codexnovus/weather_station/README.md

# ESP32 E-ink Board

This project started as a weather station powered by an ESP32 and mounted on a Waveshare 4.2 E-paper display.

Current objective is to make it a platform for developing E-ink solutions. Time will tell if I manage to do that :/
