codexnovus/weather_station/Datasheets/Shield/AZDelivery-ESP32-DevKitCV4-pinout.jpg

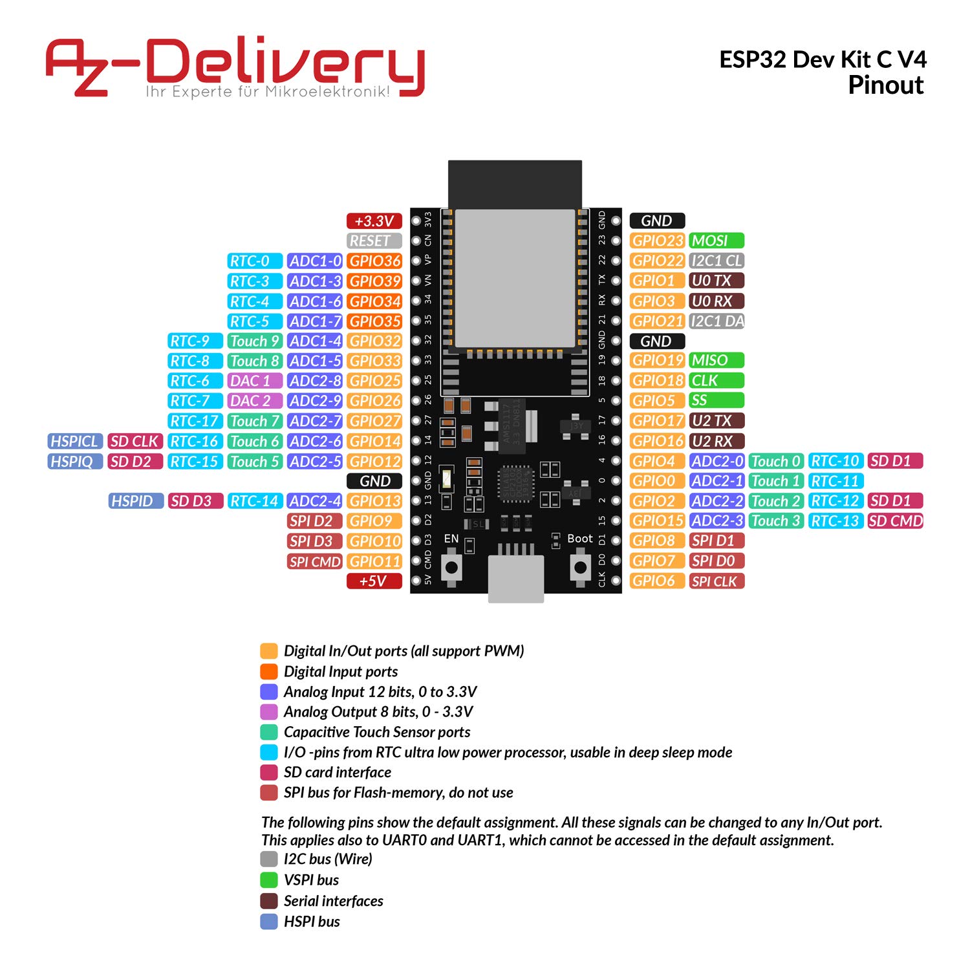
Datasheets/Shield/AZDelivery-ESP32-DevKitCV4-pinout.jpg
