codexnovus/weather_station/Models/Enclosure-Body-Preview.png

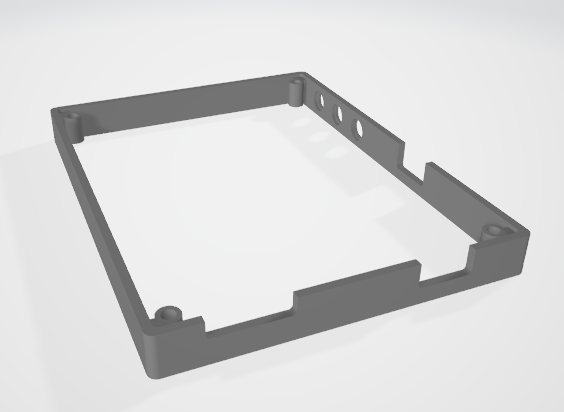
Models/Enclosure-Body-Preview.png
