codexnovus/weather_station/Models/PCB-Model-Preview.png

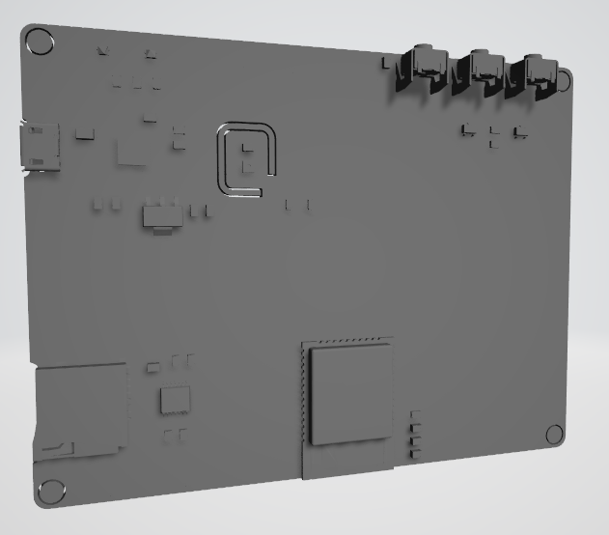
Models/PCB-Model-Preview.png
