codexnovus/weather_station/Models/Enclosure-V2.FCStd

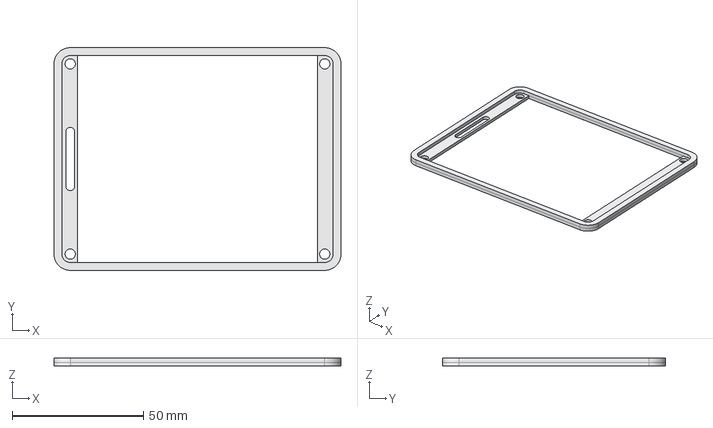
[picture p6: CAD file, 2021-06-10]
Models/Enclosure-V2.FCStd
109.4 x 84.9 x 3.20 mm
