codexnovus/weather_station/Models/Enclosure-Body.stl

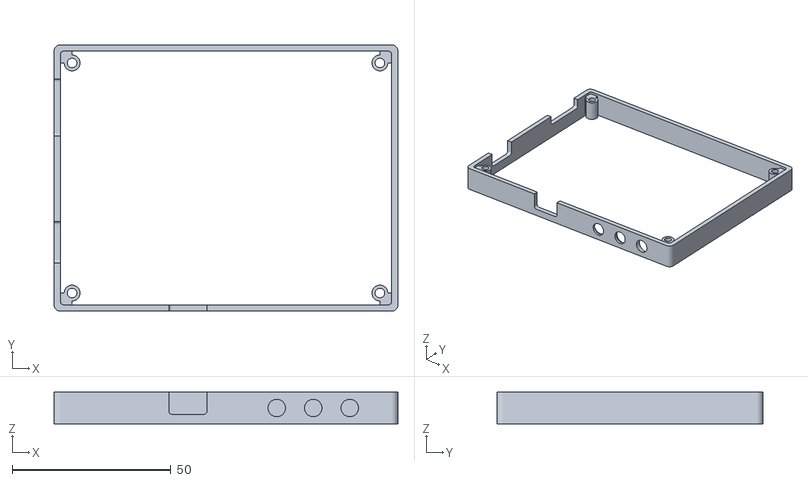
[picture p7: CAD file, 2021-05-22]
Models/Enclosure-Body.stl
108.4 x 83.9 x 10.0
