codexnovus/weather_station/Models/PCB-Model.obj

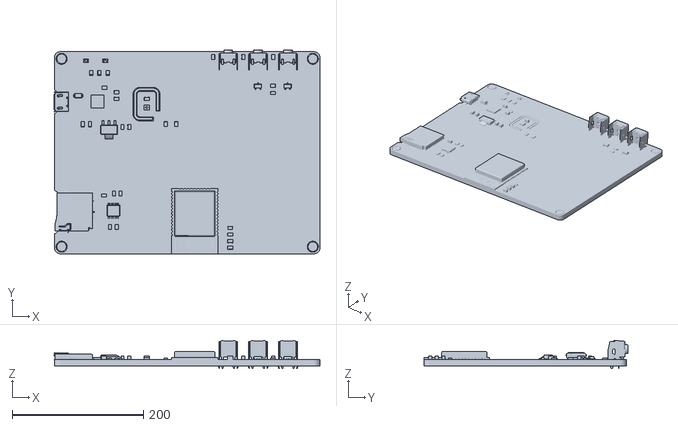
[picture p8: CAD file, 2021-05-22]
Models/PCB-Model.obj
405.0 x 311.3 x 42.8
