codexnovus/weather_station/Models/Enclosure.FCStd

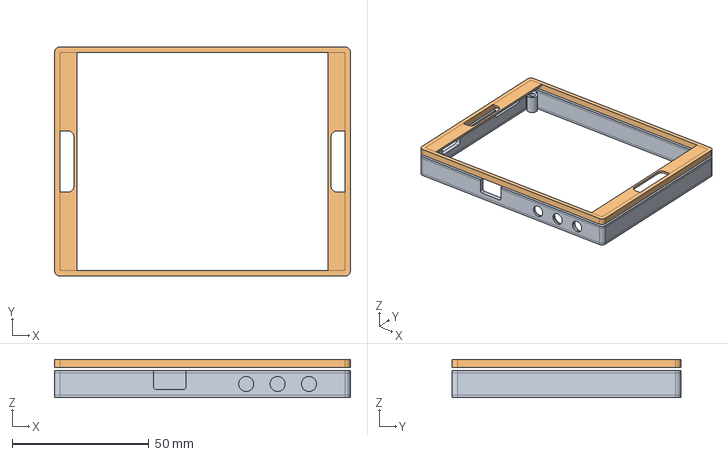
[picture p9: CAD file, 2021-05-22, an earlier design]
Models/Enclosure.FCStd
108.4 x 83.9 x 14.0 mm
Middle
Top
