codexnovus/weather_station/Boards/Shield/Schematics.pdf

## BASED on AZ-DELIVERY ESP32 DEVKIT C V4 OLDER VERSIONS HAVE DIFFERENT PINOUT!

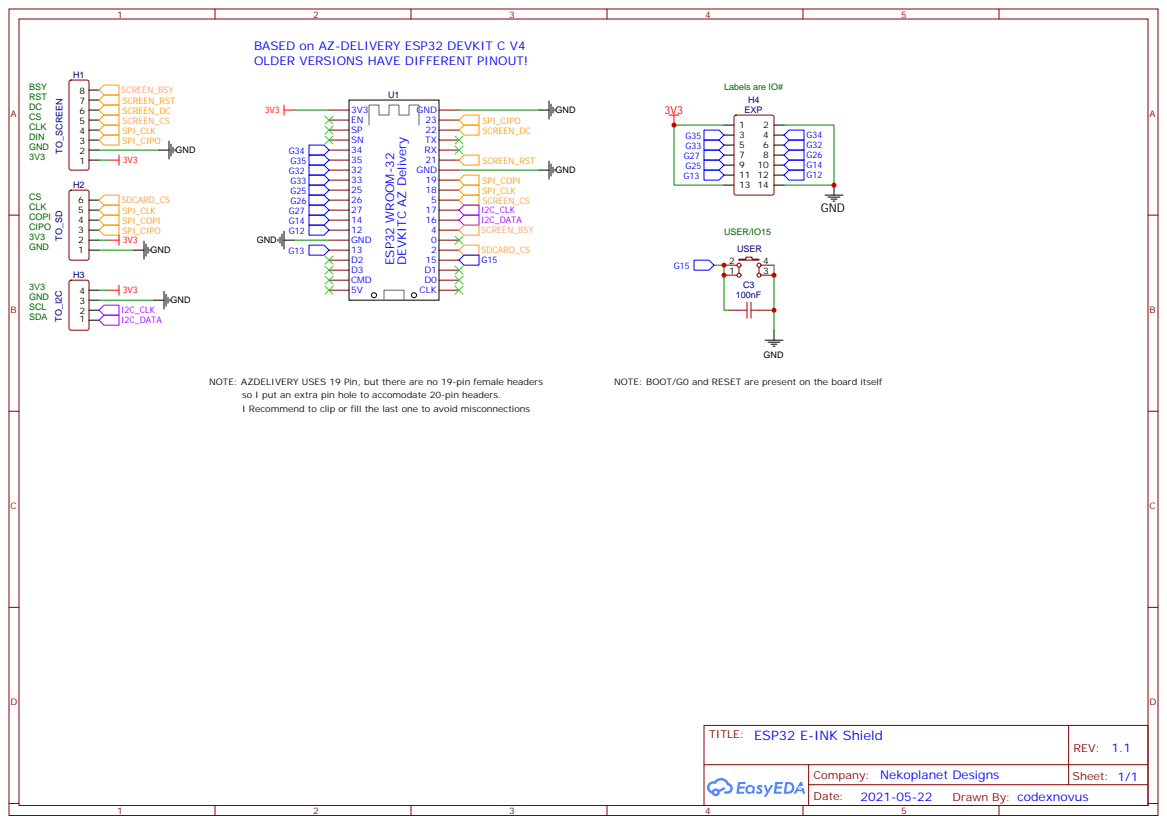
[picture p10: page 1]

NOTE: AZDELIVERY USES 19 Pin, but there are no 19-pin female headers

NOTE: BOOT/G0 and RESET are present on the board itself

so I put an extra pin hole to accomodate 20-pin headers.
I Recommend to clip or fill the last one to avoid misconnections
