codexnovus/weather_station/Boards/WROOM Board/Schematics.pdf

## U1 GND ³⁹

## GND

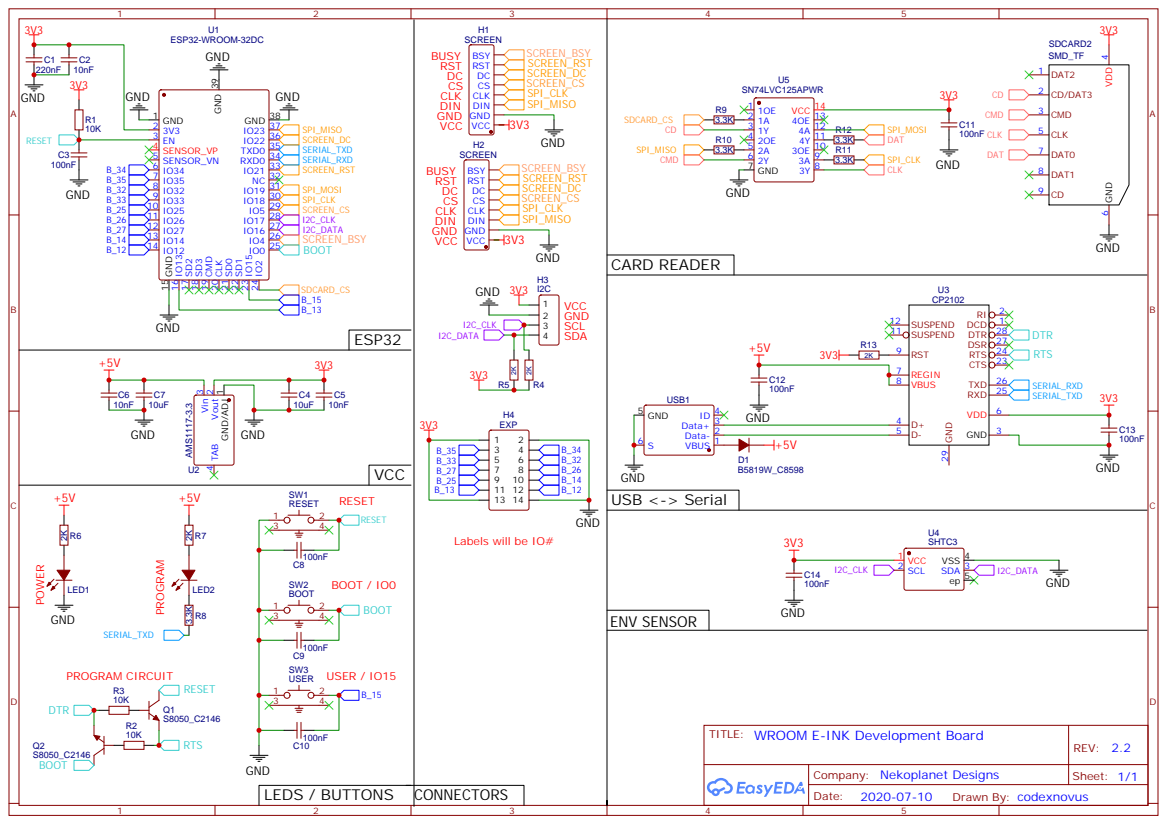
[picture p11: page 1]

IO0 25 IO² 24 IO¹⁵ 23 SD¹ 22 SD⁰ 21 CLK 20 CMD 19 SD³ 18 SD² 17 IO¹³ 16 GND 15

Labels will be IO#

TITLE: WROOM E-INK Development Board
