codexnovus/weather_station/(list of files, drawings)

Other design files:
Boards/Shield/PCB-EASYEDA.json
Boards/WROOM Board/PCB-EASYEDA.json
