codexnovus/weather_station/Boards/Shield/CHANGELOG.md

# Changelog:
**1.1:**
* Brought pin parity with WROOM Board
* Resized to fit the back of the screen. Now is slightly bigger but can be held using M3 spacers.
* Clearer Labeling
* Changed WROOM footprint
* Removed RESET and BOOT buttons as they were redundant.

**1.0:**
* Initial revision that confirmed working
