codexnovus/weather_station/Code/TestSuite/src/Monaco7.h

const uint8_t monaco7Bitmaps[] PROGMEM =
{
  0x00, 0xFA, 0xB4, 0x57, 0xD5, 0xF5, 0x00, 0x23, 0xAB, 0x47, 0x16, 0xAE, 
  0x20, 0x43, 0x49, 0x20, 0x82, 0x49, 0x61, 0x00, 0x72, 0x26, 0x20, 0x9E, 
  0x27, 0x00, 0xC0, 0x6A, 0xA4, 0x95, 0x58, 0x5D, 0x50, 0x5D, 0x00, 0x60, 
  0xE0, 0x80, 0x11, 0x22, 0x44, 0x88, 0x74, 0x67, 0x5C, 0xC5, 0xC0, 0x75, 
  0x54, 0x74, 0x42, 0x22, 0x23, 0xE0, 0x74, 0x42, 0x60, 0xC5, 0xC0, 0x11, 
  0x95, 0x2F, 0x88, 0x40, 0xFC, 0x3C, 0x10, 0xC5, 0xC0, 0x74, 0x3D, 0x18, 
  0xC5, 0xC0, 0xF8, 0x42, 0x22, 0x10, 0x80, 0x74, 0x62, 0xE8, 0xC5, 0xC0, 
  0x74, 0x63, 0x17, 0x85, 0xC0, 0x90, 0x41, 0x80, 0x2A, 0x22, 0xF0, 0x0F, 
  0x88, 0xA8, 0x74, 0x42, 0x22, 0x00, 0x80, 0x74, 0x67, 0x5A, 0xCE, 0x0F, 
  0x74, 0x63, 0xF8, 0xC6, 0x20, 0xF4, 0x63, 0xE8, 0xC7, 0xC0, 0x74, 0x61, 
  0x08, 0x45, 0xC0, 0xF4, 0x63, 0x18, 0xC7, 0xC0, 0xFC, 0x21, 0xE8, 0x43, 
  0xE0, 0xFC, 0x21, 0xE8, 0x42, 0x00, 0x74, 0x61, 0x38, 0xC5, 0xC0, 0x8C, 
  0x63, 0xF8, 0xC6, 0x20, 0xFE, 0x08, 0x42, 0x10, 0xC5, 0xC0, 0x8C, 0xA9, 
  0x8A, 0x4A, 0x20, 0x84, 0x21, 0x08, 0x43, 0xE0, 0x8E, 0xEB, 0x18, 0xC6, 
  0x20, 0x8E, 0x6B, 0x38, 0xC6, 0x20, 0x74, 0x63, 0x18, 0xC5, 0xC0, 0xF4, 
  0x63, 0xE8, 0x42, 0x00, 0x74, 0x63, 0x18, 0xC5, 0xC1, 0xF4, 0x63, 0xE8, 
  0xC6, 0x20, 0x74, 0x60, 0xE0, 0xC5, 0xC0, 0xF9, 0x08, 0x42, 0x10, 0x80, 
  0x8C, 0x63, 0x18, 0xC5, 0xC0, 0x8C, 0x62, 0xA5, 0x10, 0x80, 0x8C, 0x63, 
  0x1A, 0xEE, 0x20, 0x8C, 0x54, 0x45, 0x46, 0x20, 0x8C, 0x62, 0xA2, 0x10, 
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
  { 0, 0, 0, 0, 0, 0 },  // 0x7F '(DEL)'
  { 357, 5, 7, 6, 0, 0 },  // 0x80 '€'
  { 362, 9, 9, 10, 0, -8 }  // 0x81 ''
};

const GFXfont monaco7 PROGMEM =
{
  (uint8_t*) monaco7Bitmaps,
  (GFXglyph*) monaco7Glyphs,
  0x20, 0x81, 10
};

// Approx. 373 bytes
