codexnovus/weather_station/Code/TestSuite/src/Temperatura27.h

const uint8_t temperatura27Bitmaps[] PROGMEM =
{
  0x3C, 0x01, 0xF8, 0x0E, 0x70, 0x30, 0xC0, 0xC3, 0x03, 0x9C, 0x07, 0xE0, 
  0x0F, 0x00, 0x00, 0x3C, 0x01, 0xF0, 0x0C, 0x0F, 0x30, 0x3C, 0xC0, 0x03, 
  0x00, 0x07, 0xC0, 0x0F, 0x00, 0x00, 0x00, 0x00, 0x00, 0x00, 0x00, 0x00, 
  0x00, 0x00, 0x00, 0x00, 0x00, 0x00, 0x00, 0x00, 0x00, 0x00, 0x00, 0x00, 
  0x00, 0x00, 0x01, 0xFF, 0x07, 0xFF, 0x07, 0xFC, 0x00, 0x00, 0x00, 0x00, 
  0x00, 0x00, 0x00, 0x00, 0x00, 0x00, 0x00, 0x00, 0x00, 0x00, 0x00, 0x00, 
  0x00, 0x00, 0x00, 0x00, 0x00, 0x00, 0x00, 0x3C, 0x01, 0xF8, 0x0E, 0x70, 
  0x30, 0xC0, 0xC3, 0x03, 0x9C, 0x07, 0xE0, 0x0F, 0x00, 0x00, 0x3C, 0x01, 
  0xF0, 0x0C, 0x00, 0x30, 0x00, 0xC0, 0x03, 0x00, 0x07, 0xC0, 0x0F, 0x3C, 
  0x00, 0x7E, 0x04, 0xE7, 0x0E, 0xC3, 0x1C, 0xC3, 0x38, 0xE7, 0x70, 0x7E, 
  0xE0, 0x3D, 0xC0, 0x03, 0xBC, 0x07, 0x7E, 0x0E, 0xE7, 0x1C, 0xC3, 0x38, 
  0xC3, 0x70, 0xE7, 0x20, 0x7E, 0x00, 0x3C, 0x1F, 0xF0, 0x7F, 0xF1, 0x7F, 
  0xD7, 0x00, 0x7E, 0x00, 0xFC, 0x01, 0xF8, 0x03, 0xF0, 0x07, 0xE0, 0x0F, 
  0xC0, 0x1F, 0x80, 0x3F, 0x00, 0x74, 0x00, 0x40, 0x00, 0x10, 0x01, 0x70, 
  0x07, 0xE0, 0x0F, 0xC0, 0x1F, 0x80, 0x3F, 0x00, 0x7E, 0x00, 0xFC, 0x01, 
  0xF8, 0x03, 0xF0, 0x07, 0x5F, 0xF4, 0x7F, 0xF0, 0x7F, 0xC0, 0x00, 0x04, 
  0x00, 0x1C, 0x00, 0x38, 0x00, 0x70, 0x00, 0xE0, 0x01, 0xC0, 0x03, 0x80, 
  0x07, 0x00, 0x0E, 0x00, 0x1C, 0x00, 0x10, 0x00, 0x00, 0x00, 0x40, 0x01, 
  0xC0, 0x03, 0x80, 0x07, 0x00, 0x0E, 0x00, 0x1C, 0x00, 0x38, 0x00, 0x70, 
  0x00, 0xE0, 0x01, 0xC0, 0x01, 0x00, 0x1F, 0xF0, 0x7F, 0xF0, 0x7F, 0xD0, 
  0x00, 0x70, 0x00, 0xE0, 0x01, 0xC0, 0x03, 0x80, 0x07, 0x00, 0x0E, 0x00, 
  0x1C, 0x00, 0x38, 0x00, 0x71, 0xFF, 0x47, 0xFF, 0x17, 0xFC, 0x70, 0x00, 
  0xE0, 0x01, 0xC0, 0x03, 0x80, 0x07, 0x00, 0x0E, 0x00, 0x1C, 0x00, 0x38, 
  0x00, 0x70, 0x00, 0x5F, 0xF0, 0x7F, 0xF0, 0x7F, 0xC0, 0x1F, 0xF0, 0x7F, 
  0xF0, 0x7F, 0xD0, 0x00, 0x70, 0x00, 0xE0, 0x01, 0xC0, 0x03, 0x80, 0x07, 
  0x00, 0x0E, 0x00, 0x1C, 0x00, 0x38, 0x00, 0x71, 0xFF, 0x47, 0xFF, 0x07, 
  0xFD, 0x00, 0x07, 0x00, 0x0E, 0x00, 0x1C, 0x00, 0x38, 0x00, 0x70, 0x00, 
  0xE0, 0x01, 0xC0, 0x03, 0x80, 0x07, 0x1F, 0xF4, 0x7F, 0xF0, 0x7F, 0xC0, 
  0x00, 0x00, 0x00, 0x01, 0x00, 0x17, 0x00, 0x7E, 0x00, 0xFC, 0x01, 0xF8, 
  0x03, 0xF0, 0x07, 0xE0, 0x0F, 0xC0, 0x1F, 0x80, 0x3F, 0x00, 0x75, 0xFF, 
  0x47, 0xFF, 0x07, 0xFD, 0x00, 0x07, 0x00, 0x0E, 0x00, 0x1C, 0x00, 0x38, 
  0x00, 0x70, 0x00, 0xE0, 0x01, 0xC0, 0x03, 0x80, 0x07, 0x00, 0x04, 0x00, 
  0x00, 0x00, 0x00, 0x1F, 0xF0, 0x7F, 0xF1, 0x7F, 0xC7, 0x00, 0x0E, 0x00, 
  0x1C, 0x00, 0x38, 0x00, 0x70, 0x00, 0xE0, 0x01, 0xC0, 0x03, 0x80, 0x07, 
  0x00, 0x05, 0xFF, 0x07, 0xFF, 0x07, 0xFD, 0x00, 0x07, 0x00, 0x0E, 0x00, 
  0x1C, 0x00, 0x38, 0x00, 0x70, 0x00, 0xE0, 0x01, 0xC0, 0x03, 0x80, 0x07, 
  0x1F, 0xF4, 0x7F, 0xF0, 0x7F, 0xC0, 0x1F, 0xF0, 0x7F, 0xF1, 0x7F, 0xC7, 
  0x00, 0x0E, 0x00, 0x1C, 0x00, 0x38, 0x00, 0x70, 0x00, 0xE0, 0x01, 0xC0, 
  0x03, 0x80, 0x07, 0x00, 0x05, 0xFF, 0x07, 0xFF, 0x17, 0xFD, 0x70, 0x07, 
  0xE0, 0x0F, 0xC0, 0x1F, 0x80, 0x3F, 0x00, 0x7E, 0x00, 0xFC, 0x01, 0xF8, 
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
};

const GFXglyph temperatura27Glyphs[] PROGMEM =
{
  {   0, 14, 16, 18, 1, -27 },  // 0x2C ',' Negative Celsius 
  {  28, 15, 27, 16, 0, -27 },  // 0x2D '-' LCD Dash
  {  79, 14, 16, 18, 1, -27 },  // 0x2E '.' Positive Celsius
  { 107, 16, 16, 18, 1, -27 },  // 0x2F '/' Humidity percentage
  { 139, 15, 27, 16, 0, -27 },  // 0x30 '0' LCD 0
  { 190, 15, 23, 16, 0, -25 },  // 0x31 '1' LCD 1
  { 234, 15, 27, 16, 0, -27 },  // 0x32 '2' LCD 2
  { 285, 15, 27, 16, 0, -27 },  // 0x33 '3' LCD 3
  { 336, 15, 27, 16, 0, -27 },  // 0x34 '4' LCD 4
  { 387, 15, 27, 16, 0, -27 },  // 0x35 '5' LCD 5
  { 438, 15, 27, 16, 0, -27 },  // 0x36 '6' LCD 6
  { 489, 15, 27, 16, 0, -27 },  // 0x37 '7' LCD 7
  { 540, 15, 27, 16, 0, -27 },  // 0x38 '8' LCD 8
  { 591, 15, 27, 16, 0, -27 }   // 0x39 '9' LCD 9
};

const GFXfont temperatura27 PROGMEM =
{
  (uint8_t*) temperatura27Bitmaps,
  (GFXglyph*) temperatura27Glyphs,
  0x2C, 0x39, 28
};

// Approx. 642 bytes
