codexnovus/weather_station/(commit log)

2021-05-22 Project cleanup: - Removed old codebase (not compatible with new project) - Updated Rev1 Schematics, renamed to "Shield" - Updated Rev2 Schematics, renamed to "WROOM" - Uploaded relevant datasheets -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
    [Enclosure-Body.stl, Enclosure.FCStd, PCB-EASYEDA.json, PCB-Model.obj, Routing - EasyEDA.json]
2021-05-22 Updated documentation for Shield Board
2021-05-22 More changes to board description: - Changed render preview for Shield as screen connector was flipped. - Added Changelog and BOM for WROOM - Added description for WROOM in boards README
2021-05-22 Changes to Readme and WROOM BOM
2021-06-10 Added initial version of code Test Suite Updated enclosure model
    [Enclosure-V2.FCStd]
